LukaR57/VIN-projekt/Slike/IMG_20210514_124650.jpg

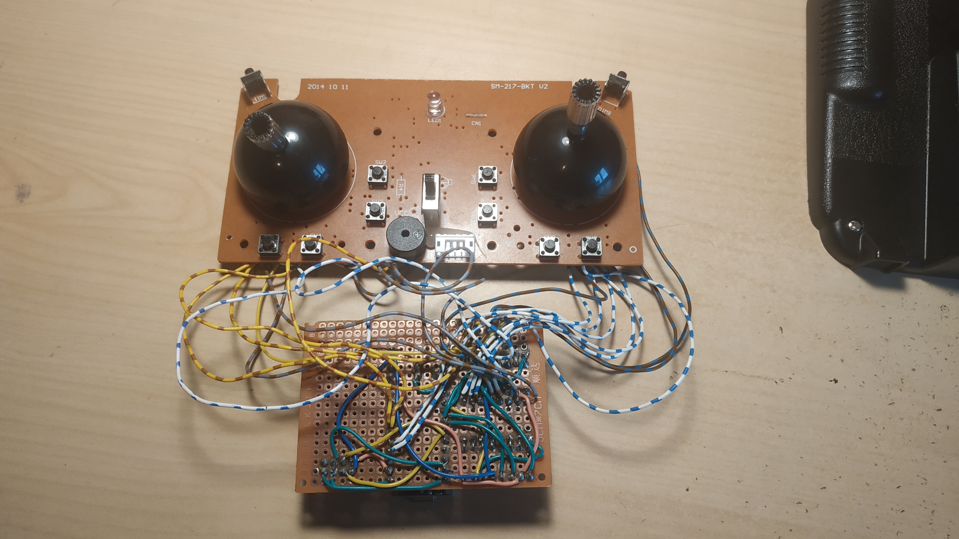
Slike/IMG_20210514_124650.jpg
