LukaR57/VIN-projekt/Slike/IMG_20210514_124725.jpg

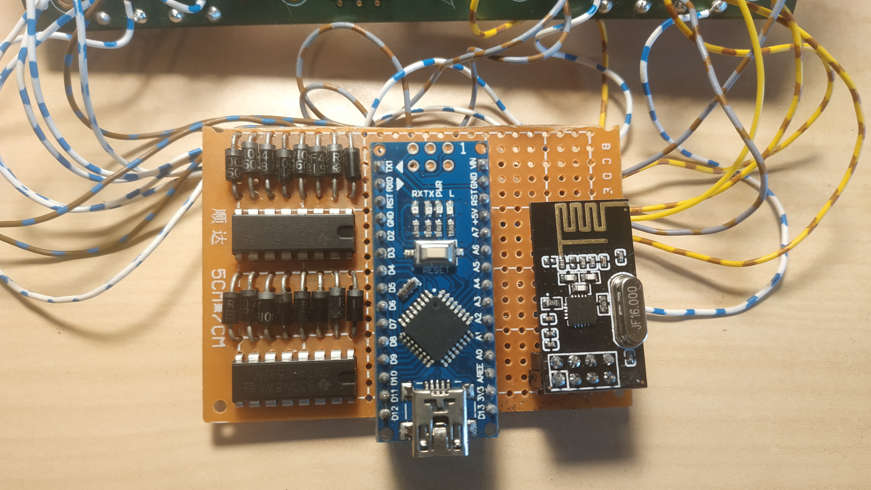
Slike/IMG_20210514_124725.jpg
