LukaR57/VIN-projekt/Slike/IMG_20210514_124556.jpg

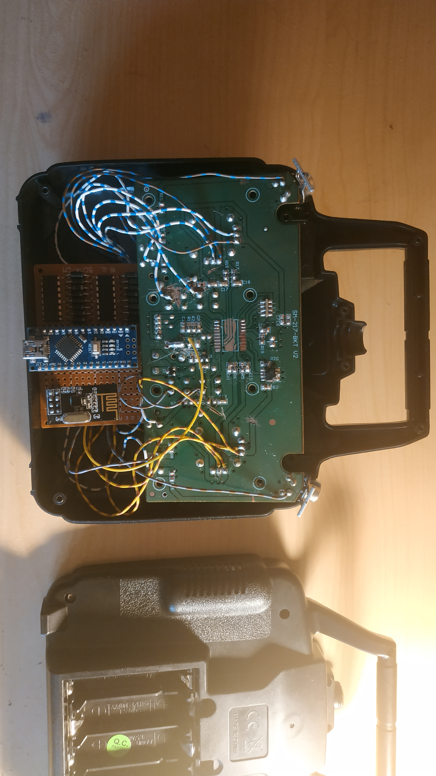
Slike/IMG_20210514_124556.jpg
