LukaR57/VIN-projekt/Slike/IMG_20210514_124611.jpg

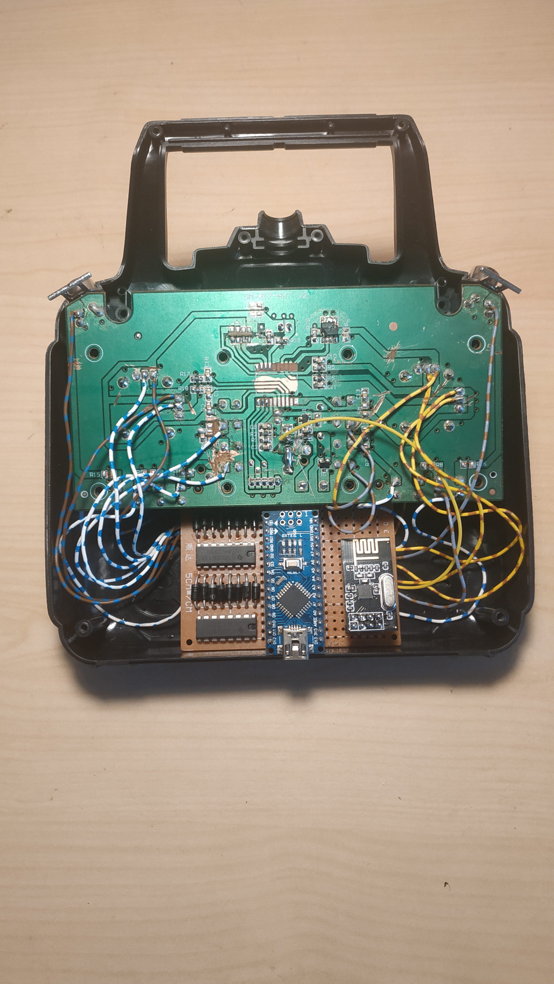
Slike/IMG_20210514_124611.jpg
