LukaR57/VIN-projekt/Slike/IMG_20210514_124738.jpg

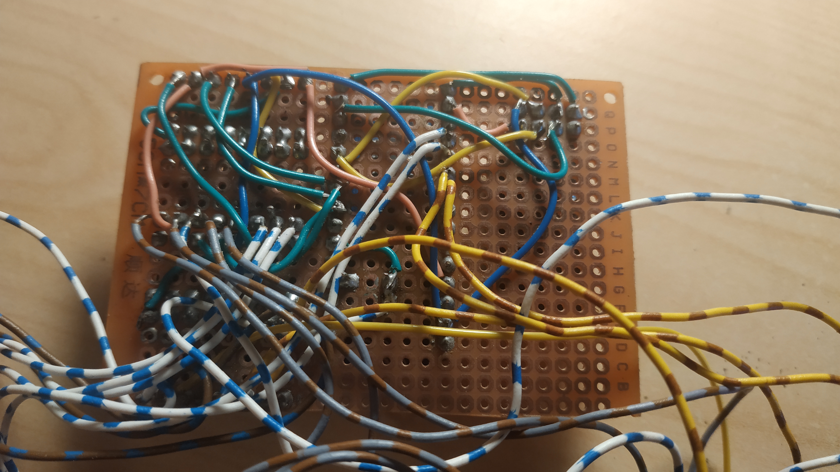
Slike/IMG_20210514_124738.jpg
