LukaR57/VIN-projekt/Slike/IMG_20210514_124758.jpg

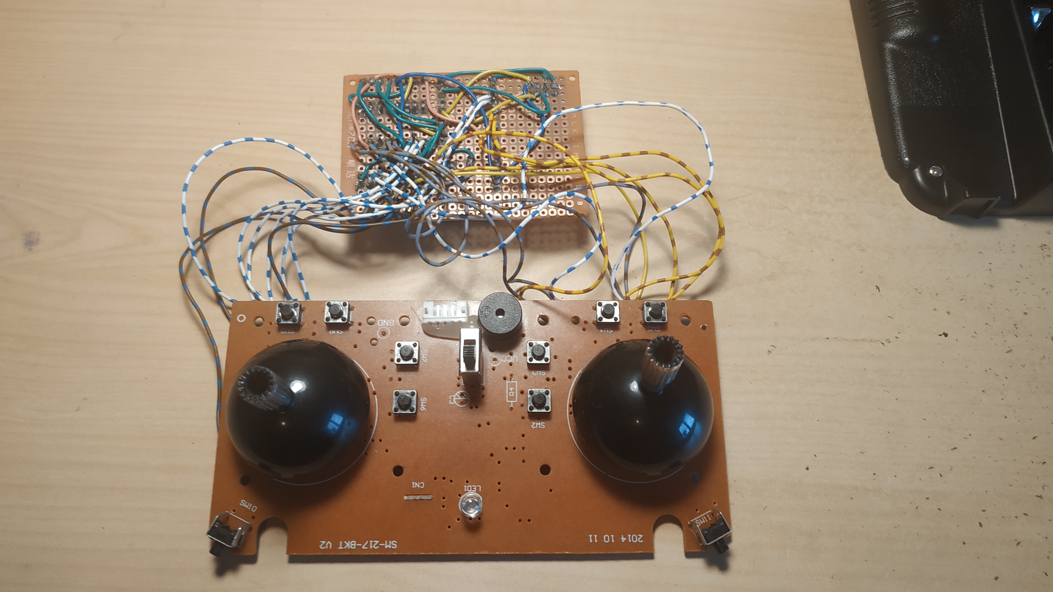
Slike/IMG_20210514_124758.jpg
