LukaR57/VIN-projekt/Slike/IMG_20210514_124831.jpg

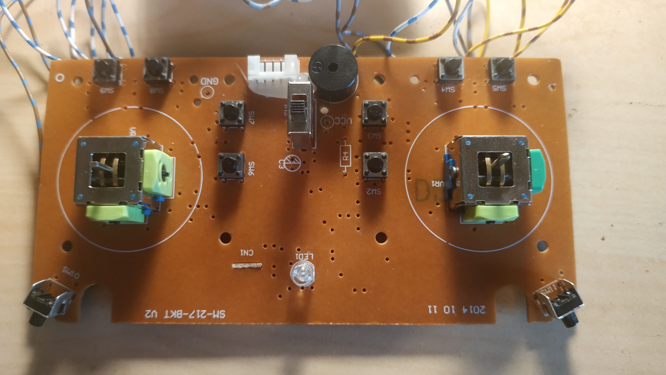
Slike/IMG_20210514_124831.jpg
