LukaR57/VIN-projekt/Slike/IMG_20210514_125458.jpg

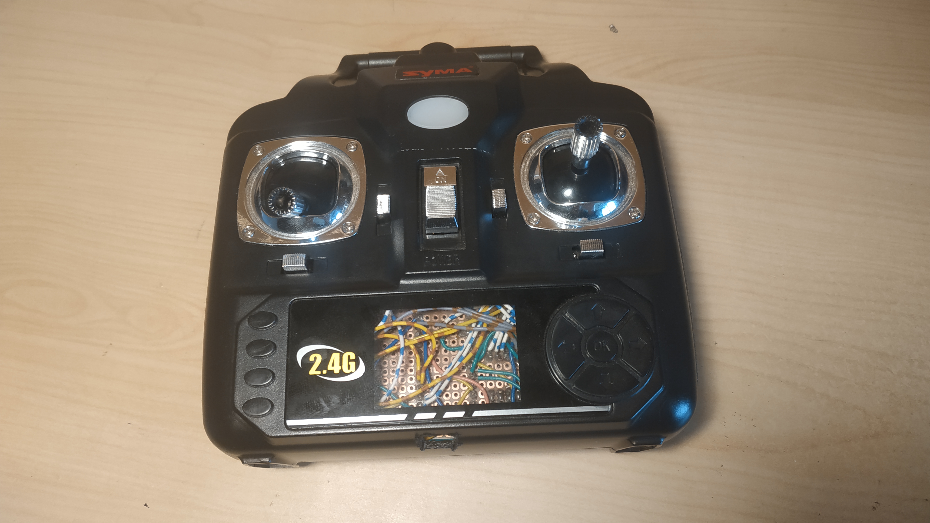
Slike/IMG_20210514_125458.jpg
