LukaR57/VIN-projekt/Slike/IMG_20210523_113743.jpg

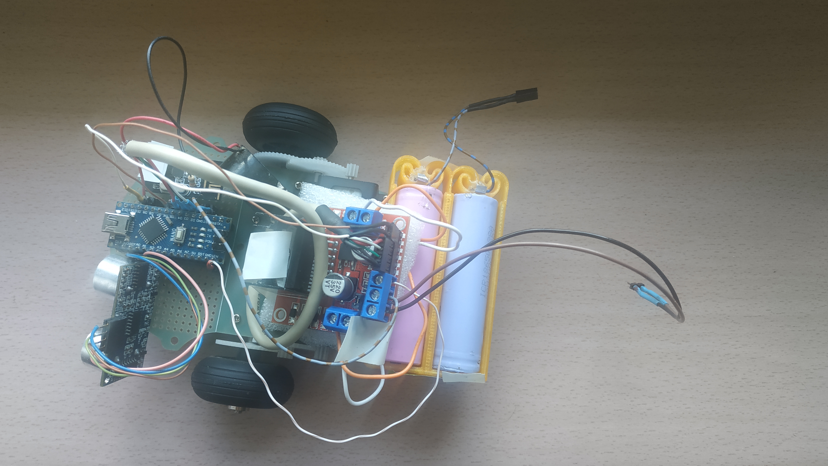
Slike/IMG_20210523_113743.jpg
