LukaR57/VIN-projekt/Slike/IMG_20210523_113813.jpg

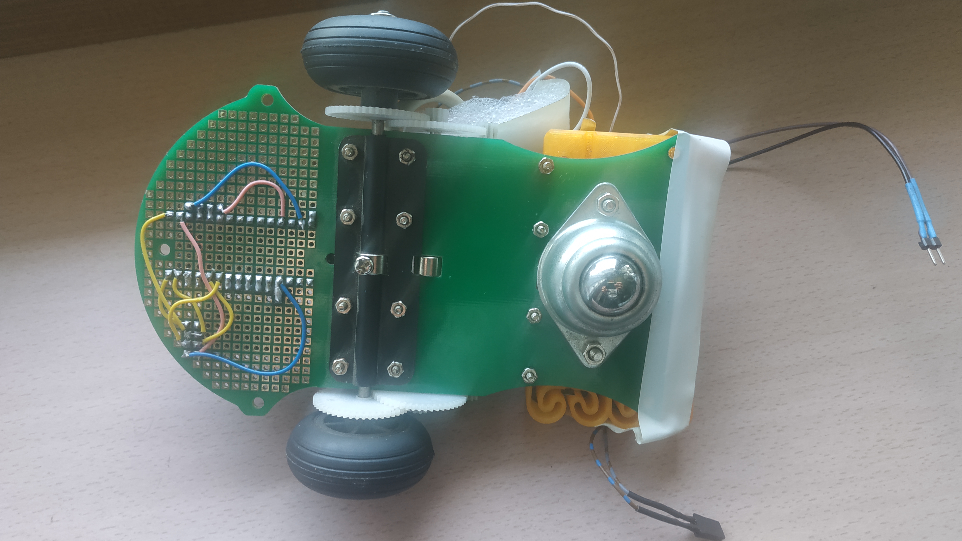
Slike/IMG_20210523_113813.jpg
