LukaR57/VIN-projekt/Slike/IMG_20210523_151736.jpg

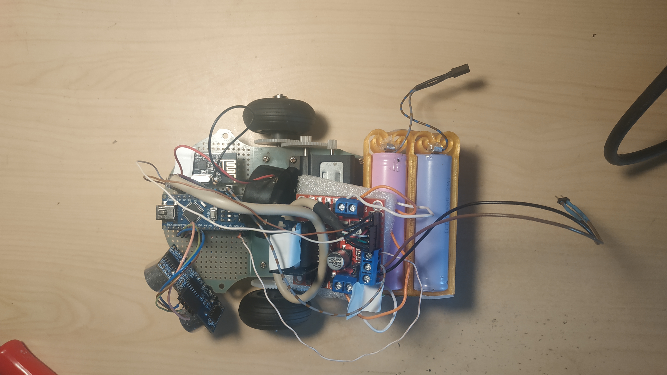
Slike/IMG_20210523_151736.jpg
